fernandogabrieu/fire-detector/Diagrams-Routings/PCB-Routing-Tracks.png

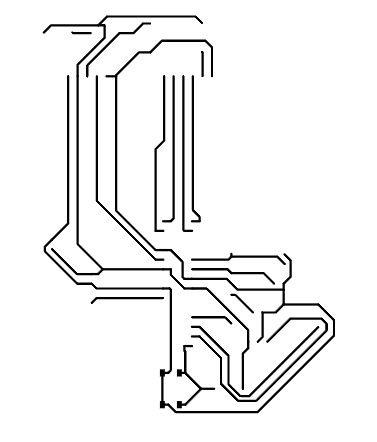
Diagrams-Routings/PCB-Routing-Tracks.png
