fernandogabrieu/fire-detector/Diagrams-Routings/PCB-Routing.png

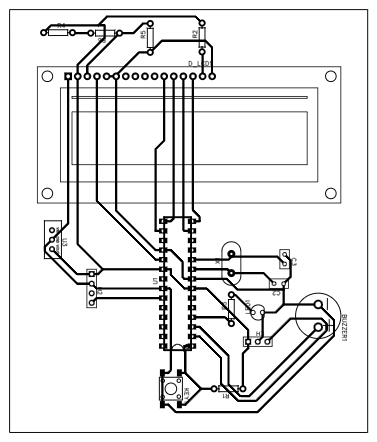
Diagrams-Routings/PCB-Routing.png
